glebmih/Hydro_USBL/Filter/V1/DesignFiles (2)/Design.pdf

## Filter Wizard

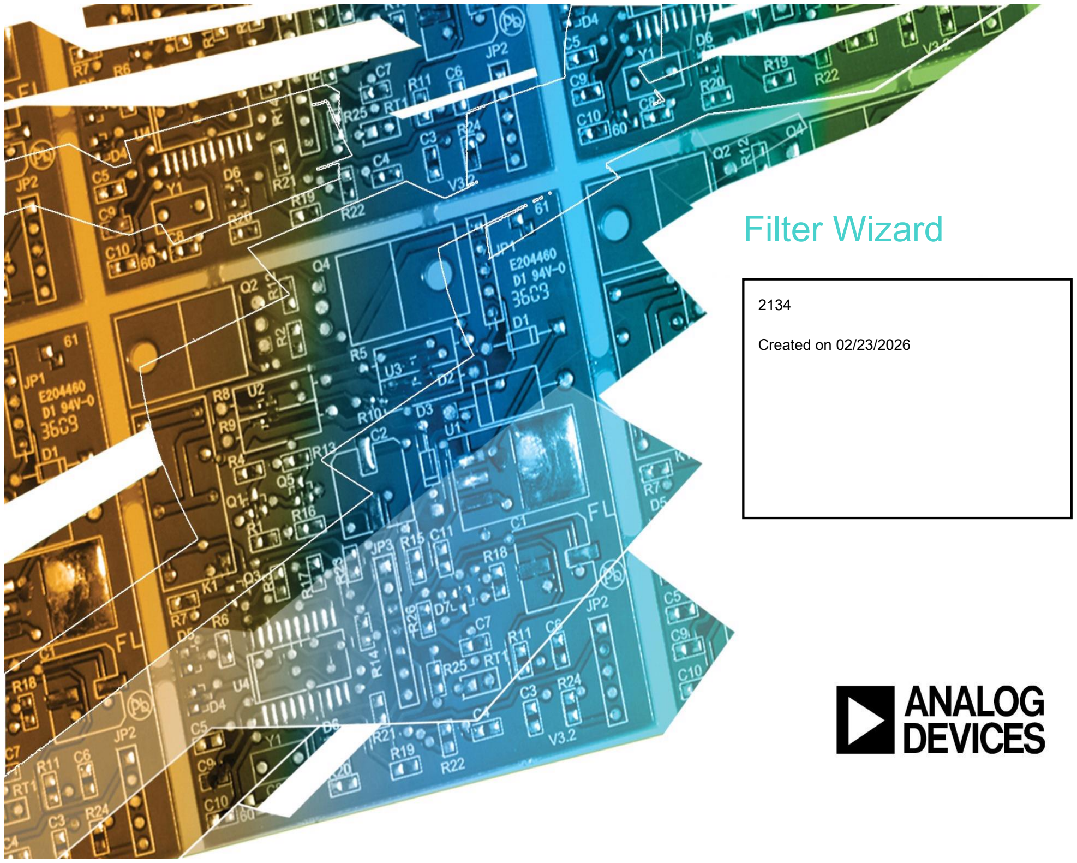
[picture p1: page 1]

2134

Created on 02/23/2026

## Filter Wizard Design Report

Filter Requirements for Band-Pass, 4th order Chebyshev Specifications: Optimize: Specific Parts; +Vs: 3.3; -Vs: 0
Gain: 40 dB
Passband: -3dB at 15kHz
Stopband: -40dB at 150kHz
Component Tolerances: Capacitor = 5%; Resistor = 1%; Inductor = 5%; Op Amp GBW = 20% BOM: refer to BOM.csv file

Magnitude(dB)

Magnitude(Volts per Volt)

Phase(degrees)

Phase(radians)

Group Delay

Phase Delay

Step Response

Input Impedance Magnitude

Input Impedance Phase

Noise

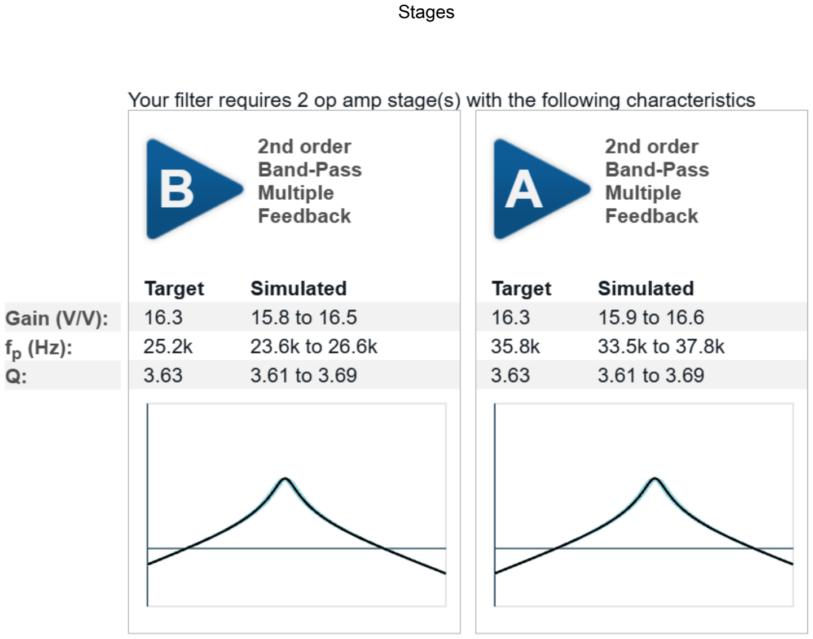
[picture p2: page 13]

Stages

Circuit

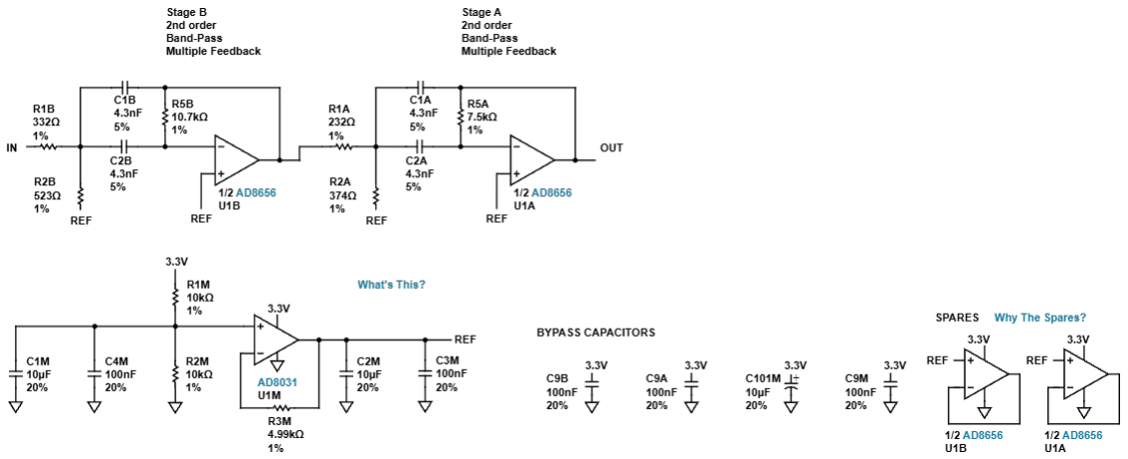
[picture p3: figure]
