glebmih/Hydro_USBL/Filter/V2/DesignFiles (1)/Design.pdf

## Filter Wizard

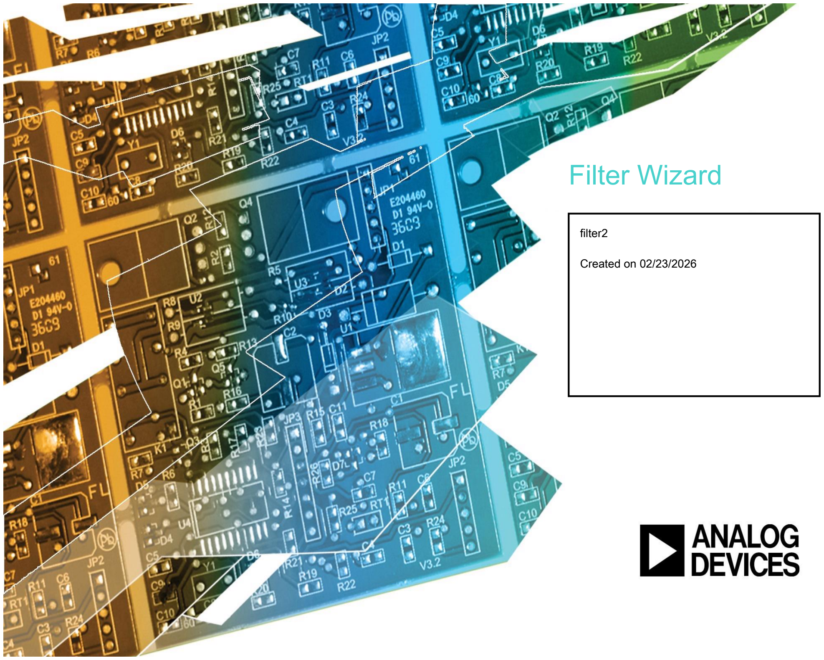
[picture p4: page 1]

filter2

Created on 02/23/2026

## Filter Wizard Design Report

Filter Requirements for Band-Pass, 8th order Butterworth Specifications: Optimize: Noise; +Vs: 3.3; -Vs: 0
Gain: 40 dB
Passband: -1dB at 10kHz
Stopband: -40dB at 40kHz
Component Tolerances: Capacitor = 5%; Resistor = 1%; Inductor = 5%; Op Amp GBW = 20% BOM: refer to BOM.csv file

Magnitude(dB)

Magnitude(Volts per Volt)

Phase(degrees)

Phase(radians)

Group Delay

Phase Delay

Step Response

Input Impedance Magnitude

Input Impedance Phase

Noise

Stages

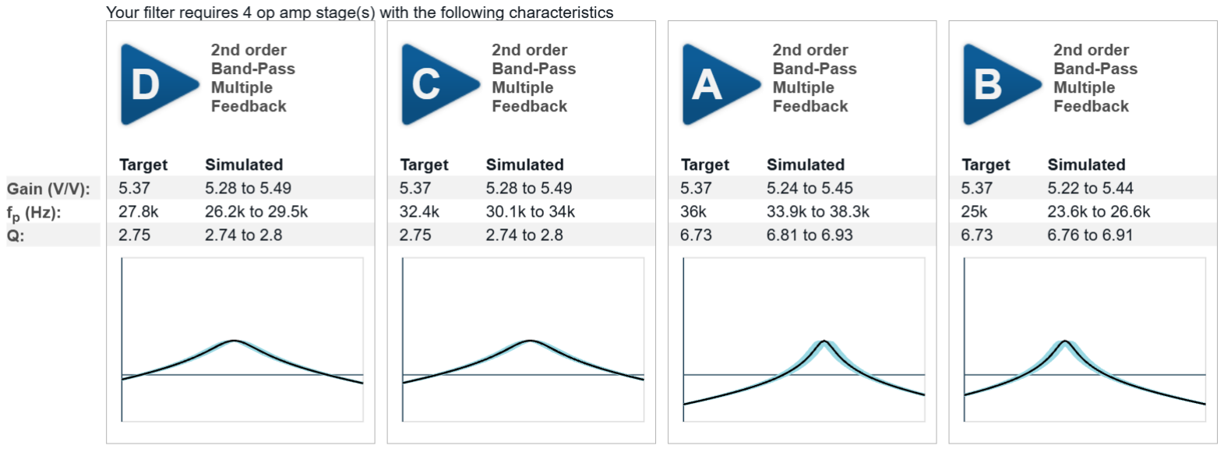
[picture p5: figure]

Circuit

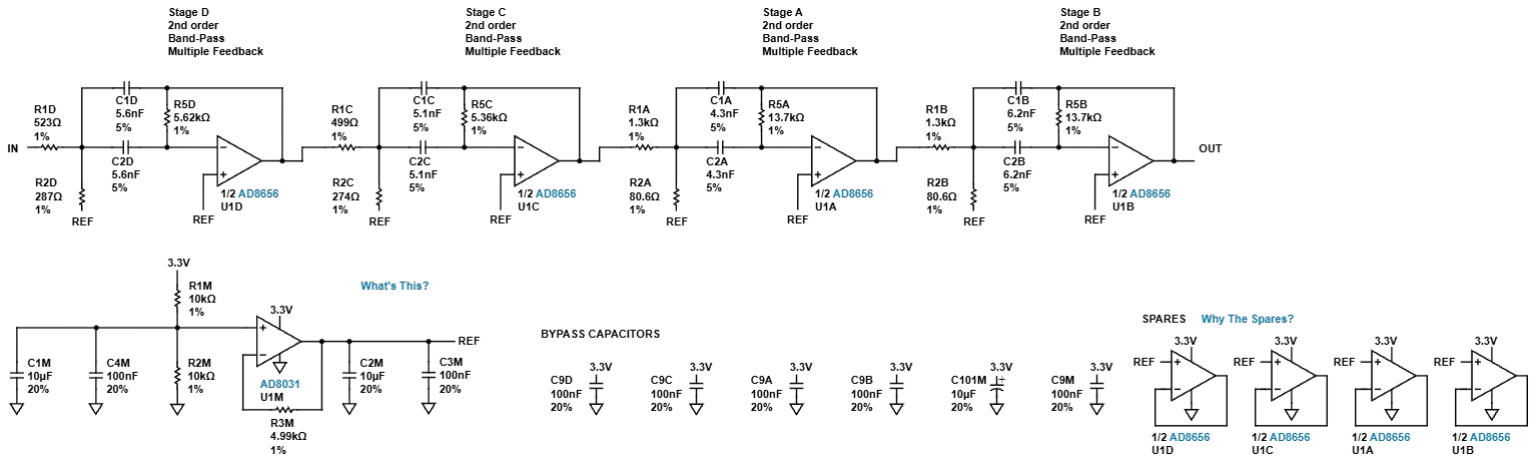
[picture p6: figure]
