glebmih/Hydro_USBL/PCB/Hydro_USBL_PCB/Project Outputs for Hydro_USBL_PCB/Hydro_USBL_PCB.xlsx

Line # | Library Reference | Name | Description | Designator | Quantity
 | Capacitor_10u_10_35V_X7R_1210C | Capacitor | Конденсатор 1210C ёмкостью 10 мк 10%, 35 В, X7R | C1, C3, C8, C11, C51, C56, C60 | 7
 | Capacitor_0,1u_10_50V_X7R_0603C | Capacitor | Конденсатор 0603C ёмкостью 0,1 мк 10%, 50 В, X7R | C2, C4, C22A, C22B, C22C, C22D, C23A, C23B, C23C, C23D, C24A, C24B, C24C, C24D, C28A, C28B, C28C, C28D, C31A, C31B, C31C, C31D, C36, C37, C38, C39, C42, C43, C44, C49, C50, C52, C53, C61, C67 | 35
 | Capacitor_1u_10_25V_X7R_0603C | Capacitor | Конденсатор 0603C ёмкостью 1 мк 10%, 25 В, X7R | C5, C6, C40, C41, C59, C63 | 6
 | 50SVPF68M | Capacitor | Конденсатор алюминиевый полимерный 68мкФ 50В ±20% (10х12.6мм) для поверхностного монтажа 0.02Ом 4300мА 5000час 105°С | C7, C9 | 2
 | Capacitor_1n_5_50V_NP0_0603C | Capacitor | Конденсатор 0603C ёмкостью 1 н 5%, 50 В, NP0 | C10, C15, C20A, C20B, C20C, C20D | 6
 | Capacitor_100p_5_630V_NP0_1206C | Capacitor | Конденсатор 1206C ёмкостью 100 п 5%, 630 В, NP0 | C19A, C19B, C19C, C19D | 4
 | Capacitor_10u_10_10V_X7R_0603C | Capacitor | Конденсатор 0603C ёмкостью 10 мк 10%, 10 В, X7R | C21A, C21B, C21C, C21D, C27A, C27B, C27C, C27D | 8
 | Capacitor_3.3n_5_50V_NP0_0603C | Capacitor | Конденсатор 0603C ёмкостью 3,3 н 5%, 50 В, NP0 | C25A, C25B, C25C, C25D, C26A, C26B, C26C, C26D, C29A, C29B, C29C, C29D, C30A, C30B, C30C, C30D, C32A, C32B, C32C, C32D, C33A, C33B, C33C, C33D, C54, C62 | 26
 | Capacitor_4,7u_10_50V_X7R_1206C | Capacitor | Конденсатор 1206C ёмкостью 4,7 мк 10%, 50 В, X7R | C34 | 1
 | Capacitor_0,47u_10_50V_X7R_0603C | Capacitor | Конденсатор 0603C ёмкостью 0,47 мк 10%, 50 В, X7R | C35 | 1
 | Capacitor_2,2u_10_50V_X7R_1206C | Capacitor | Конденсатор 1206C ёмкостью 2,2 мк 10%, 50 В, X7R | C45, C46 | 2
 | Capacitor_12p_5_50V_NP0_0603C | Capacitor | Конденсатор 0603C ёмкостью 12 п 5%, 50 В, NP0 | C47, C48 | 2
 | Capacitor_22u_10_25V_X7R_1210C | Capacitor | Конденсатор 1210C ёмкостью 22 мк 10%, 25 В, X7R | C55, C57, C58, C64, C65, C66 | 6
 | LD1117S33CTR | LD1117S33CTR | Линейный стабилизатор напряжения | D1 | 1
 | AD8031 | AD8031 | Операционный усилитель, 80МГц, 1-канал, 35В/мкс, Voltage Feedback, Rail-to-Rail | DA1A, DA1B, DA1C, DA1D | 4
 | REF3030AIDBZR | REF3030AIDBZR | Источник опорного напряжения, 3В | DA2 | 1
 | AP63200 | AP63200 | DC-DC понижающий преобразователь, Vin: 3.8 - 40 В, adj, 2 А | DA3, DA4 | 2
 | ADP150AUJZ-3.3 | ADP150AUJZ-3.3 | Стабилизатор напряжения 3.3В 150мА | DA5 | 1
 | UCC27211 | UCC27211 | Полумостовой драйвер затвора для mosfet транзисторов | DD1, DD2 | 2
 | AD8656 | AD8656 | Операционный усилитель 28МГц, CMOS, 2-канала, Rail-to-Rail | DD3A, DD3B, DD3C, DD3D, DD4A, DD4B, DD4C, DD4D | 8
 | STM32H743VIT6 | STM32H743VIT6 | Микроконтроллер, 32-Бит, Cortex-M7, 480МГц, 2Мб Flash, 1Мб SRAM, 82 I/O | DD5 | 1
 | MAX485CSA | MAX485CSA | RS-485 приёмопередатчик | DD6 | 1
 | BLM18AG102SN1D | BLM18AG102SN1D | Дроссель подавления ЭМП | FB1 | 1
 | LED | LED | Светодиод | HL1 | 1
 | LED | LED | Светодиод | HL2 | 1
 | LED | LED | Светодиод | HL3, HL4 | 2
 | Inductance_RM8 | Inductance_RM8 | Индуктивность на сердечнике RM8 | L1 | 1
 | SP43-150K | SP43-150K | Индуктивность на 15 мкГн, номинальный ток 1,3 А | L2, L3 | 2
 | Resistor_10k_1_0603 | Resistor | Резистор номиналом 10 кОм 1% | R1, R2, R3, R4, R19A, R19B, R19C, R19D, R20A, R20B, R20C, R20D, R32, R41, R46, R49, R53, R54 | 18
 | Resistor_3.3_1_0603 | Resistor | Резистор номиналом 3,3 Ом 1% | R5, R6, R7, R8 | 4
 | Resistor_47_1_0805 | Resistor | Резистор номиналом 47 Ом 1% | R9, R10 | 2
 | Resistor_33_1_2512 | Resistor | Резистор номиналом 33 Ом 1% | R11, R12, R13, R14 | 4
 | Resistor_1k_0805 | Resistor | Резистор номиналом 1 кОм 1% | R15A, R15B, R15C, R15D | 4
 | Resistor_1.0k_1_0603 | Resistor | Резистор номиналом 1,0 кОм 1% | R16A, R16B, R16C, R16D, R44, R45, R47, R50, R52 | 9
 | Resistor_470k_1_0603 | Resistor | Резистор номиналом 470 кОм 1% | R17A, R17B, R17C, R17D | 4
 | Resistor_12k_1_0603 | Resistor | Резистор номиналом 12 кОм 1% | R18A, R18B, R18C, R18D | 4
 | Resistor_8.2k_1_0603 | Resistor | Резистор номиналом 8,2 кОм 1% | R21A, R21B, R21C, R21D | 4
 | Resistor_620_1_0603 | Resistor | Резистор номиналом 620 Ом 1% | R22A, R22B, R22C, R22D | 4
 | Resistor_4.7k_1_0603 | Resistor | Резистор номиналом 4,7 кОм 1% | R23A, R23B, R23C, R23D, R24A, R24B, R24C, R24D | 8
 | Resistor_560_1_0603 | Resistor | Резистор номиналом 560 Ом 1% | R25A, R25B, R25C, R25D, R28A, R28B, R28C, R28D | 8
 | Resistor_220_1_0603 | Resistor | Резистор номиналом 220 Ом 1% | R26A, R26B, R26C, R26D, R31A, R31B, R31C, R31D | 8
 | Resistor_6.2k_1_0603 | Resistor | Резистор номиналом 6,2 кОм 1% | R27A, R27B, R27C, R27D | 4
 | Resistor_1.5k_1_0603 | Resistor | Резистор номиналом 1,5 кОм 1% | R29A, R29B, R29C, R29D | 4
 | Resistor_16k_1_0603 | Resistor | Резистор номиналом 16 кОм 1% | R30A, R30B, R30C, R30D | 4
 | Resistor_200_1_0603 | Resistor | Резистор номиналом 200 Ом 1% | R33, R34, R35, R36 | 4
 | Resistor_0_5_0603 | Resistor | Резистор номиналом 0 Ом 5% | R42, R43 | 2
 | Resistor_5.1k_1_0603 | Resistor | Резистор номиналом 5,1 кОм 1% | R48 | 1
 | Resistor_11k_1_0603 | Resistor | Резистор номиналом 11 кОм 1% | R51 | 1
 | Resistor_120_1_1206 | Resistor | Резистор номиналом 120 Ом 1% | R55 | 1
 | Resistor_100k_1_0603 | Resistor | Резистор номиналом 100 кОм 1% | R56 | 1
 | TSS-TD-19XA-XTR | TSS-TD-19XA-XTR | Тактовая кнопка | S1, S2 | 2
 | Transformer_RM8 | Transformer_RM8 | Трансформатор на сердечнике RM8 | T1 | 1
 | SMA4007 | SMA4007 | Выпрямительный диод на 1000 В, ном. ток 1 А А | VD1, VD2 | 2
 | BAV99 | BAV99 | Диод импульсный, 2 х 0.2А, 70В, последовательное включение | VD3A, VD3B, VD3C, VD3D | 4
 | PSM712 | PSM712 | Защитный диод для линии RS-485 | VD4 | 1
 | USBLC6-4 | USBLC6-4 | Сборка защитных диодов для USB | VD5, VD7 | 2
 | BZV55-B12 | BZV55-B12 | Стабилитрон 12В, 5%, 0.5Вт | VD6 | 1
 | CSD18534Q5A | CSD18534Q5A | N-канальный MOSFET, 60 В, 50 А | VT1, VT2, VT3, VT4 | 4
 | AO3401A | AO3401A | P-канальный MOSFET | VT5 | 1
 | IRF9310TR | IRF9310TR | P-канальный MOSFET, 30 В, 20 А | VT6 | 1
 | XT30UPB-M | XT30UPB-M | 2-пиновый разъем с ключом | XP1 | 1
 | CWF-2 | CWF-2 | 2-пиновый разъем с ключом | XP2, XP4, XP5, XP6, XP7, XP8 | 6
 | PLS-6 | PLS-6 | Гребенка 6 пинов | XP3 | 1
 | X322525MOB4SI | X322525MOB4SI | Кварцевый резонатор SMD 25 МГц ±10ppm SMD-3225_4P | ZQ1 | 1
