glebmih/Hydro_USBL/(list of files, cad)

Other CAD files:
PCB/Hydro_USBL_PCB/Project Outputs for Hydro_USBL_PCB/ГИДР.123456.023-01.01/Mechanical models/Hydro_USBL_PCB(01).x_t
