glebmih/Hydro_USBL/PCB/Hydro_USBL_PCB/Project Outputs for Hydro_USBL_PCB/Sources/Документация/ГИДР.123456.023-01.[No Variations] СБ.PDF

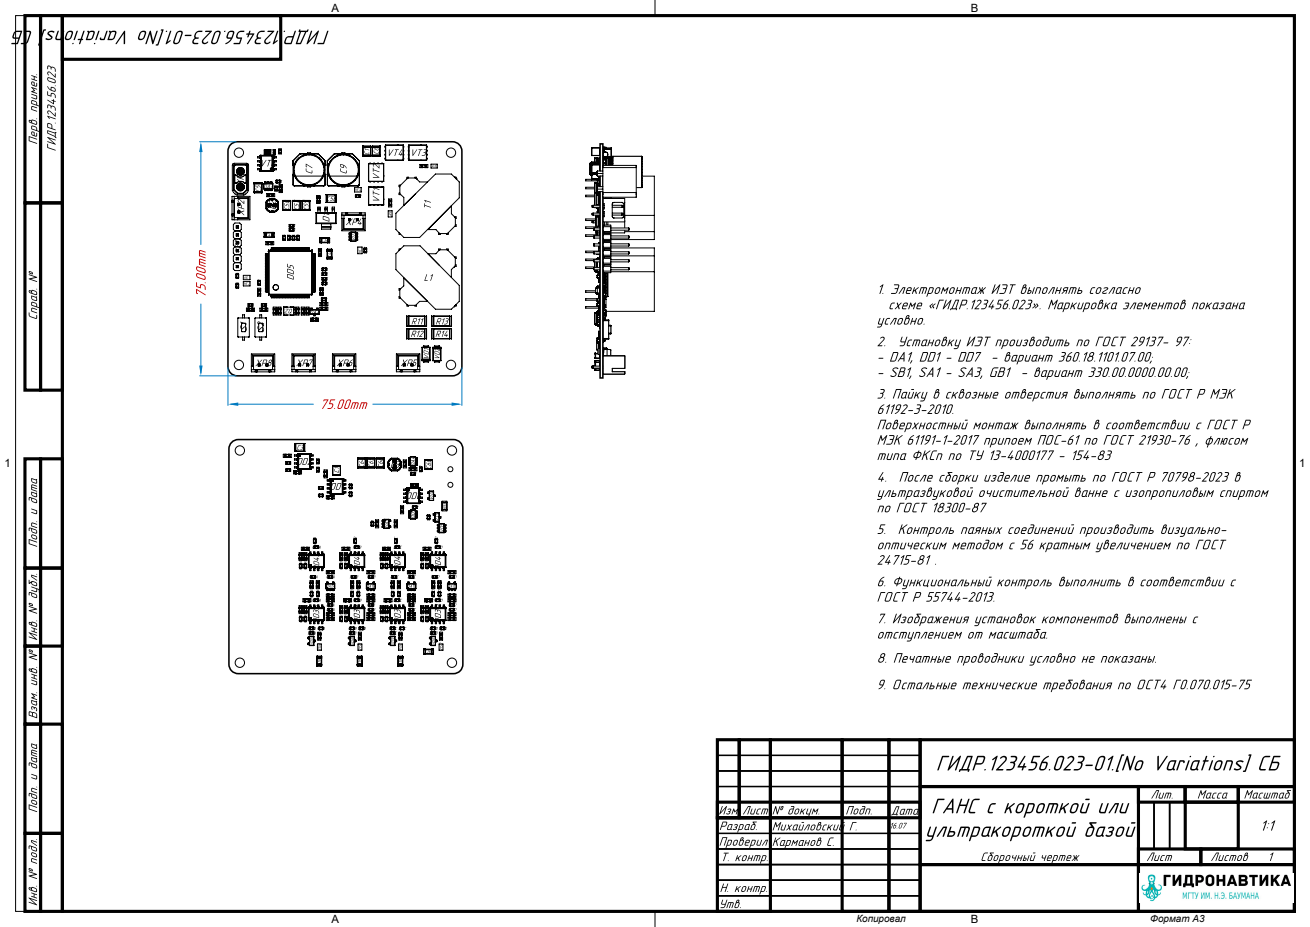
[picture p7: page 1]
