glebmih/Hydro_USBL/PCB/Hydro_USBL_PCB/Project Outputs for Hydro_USBL_PCB/Sources/Документация/ГИДР.123456.023-01.[No Variations] Э3.PDF

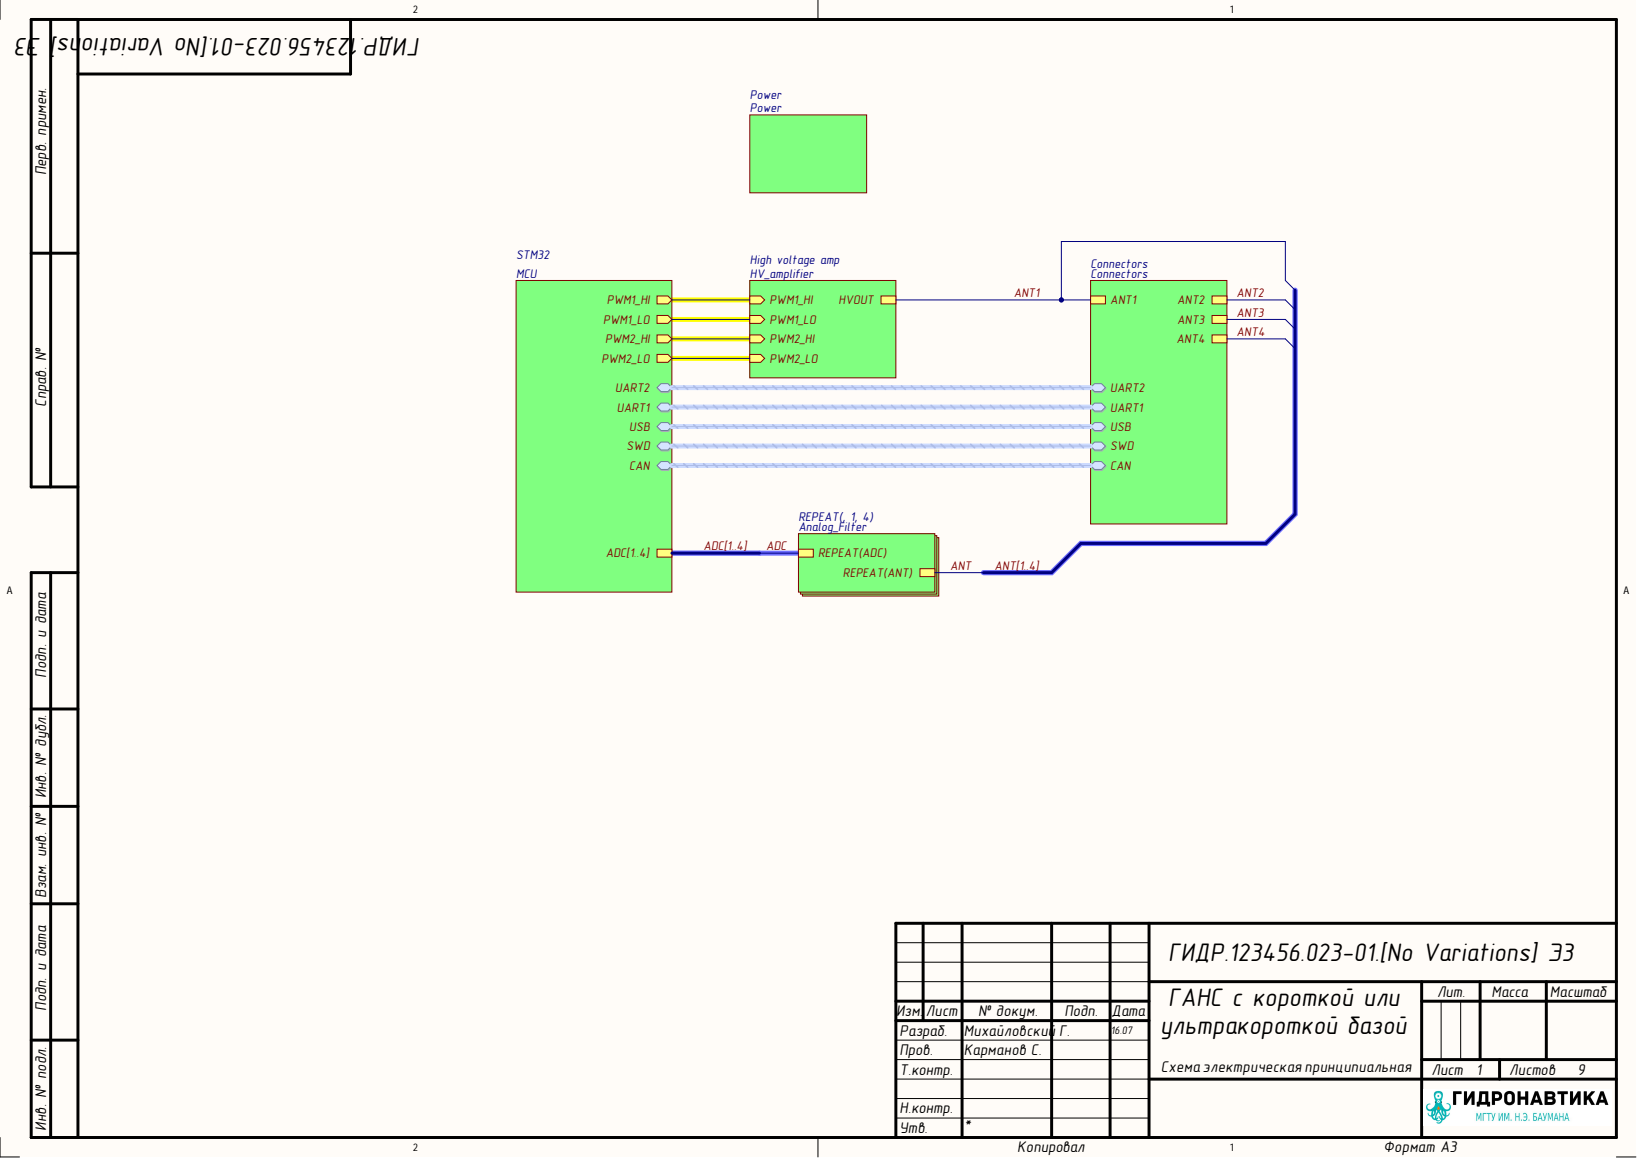
[picture p8: page 1]

ГИДР.123456.023-01.[No Variations] Э3

ГАНС с короткой или ультракороткой базой Схема электрическая принципиальная | Лит. | Масса | Масштаб

Изм. | Лист | № докум. | Подп. | Дата
Разраб. | | Михайловский Г. | | 16.07
Пров. | | Карманов С.
Т.контр. | | | | | Лист | Листов 9

Н.контр.
Утв. | *

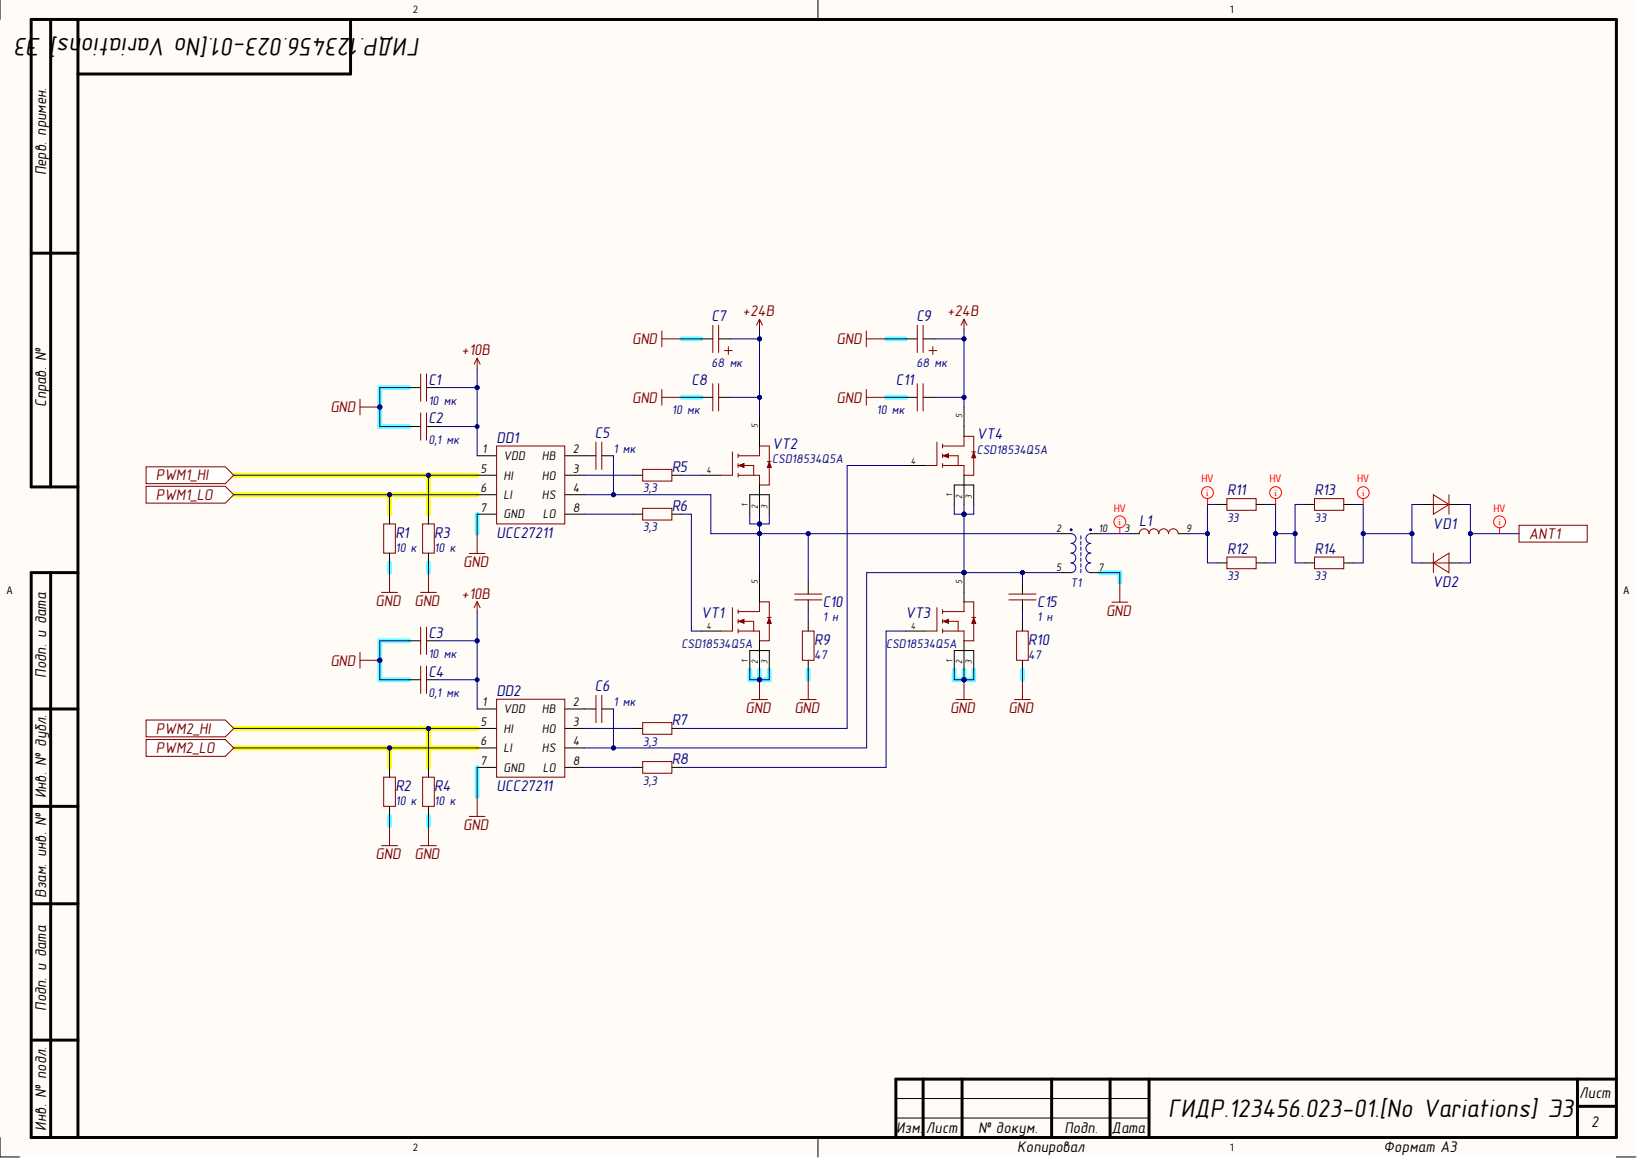
[picture p9: page 2]

Инв. № подл. Инв. № дубл. Подп. и дата Взам. инв. № Подп. и дата Перв. примен. Справ. №

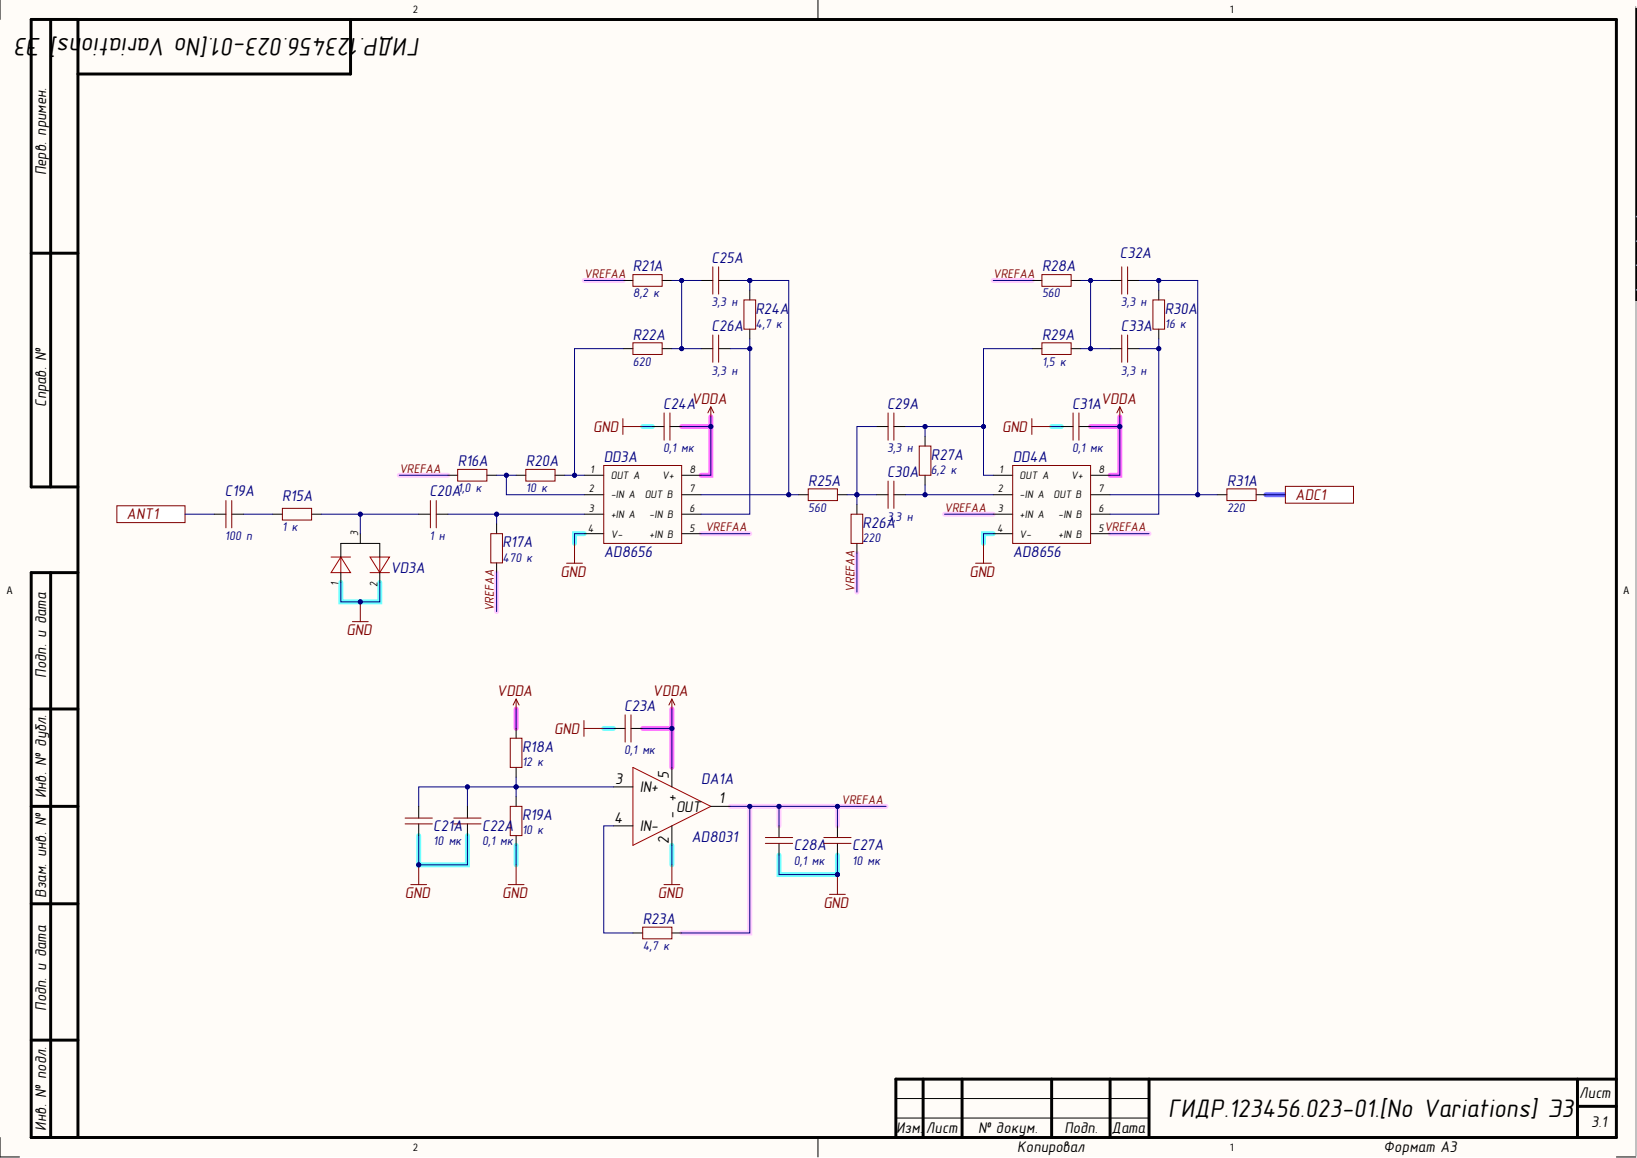
[picture p10: page 3]

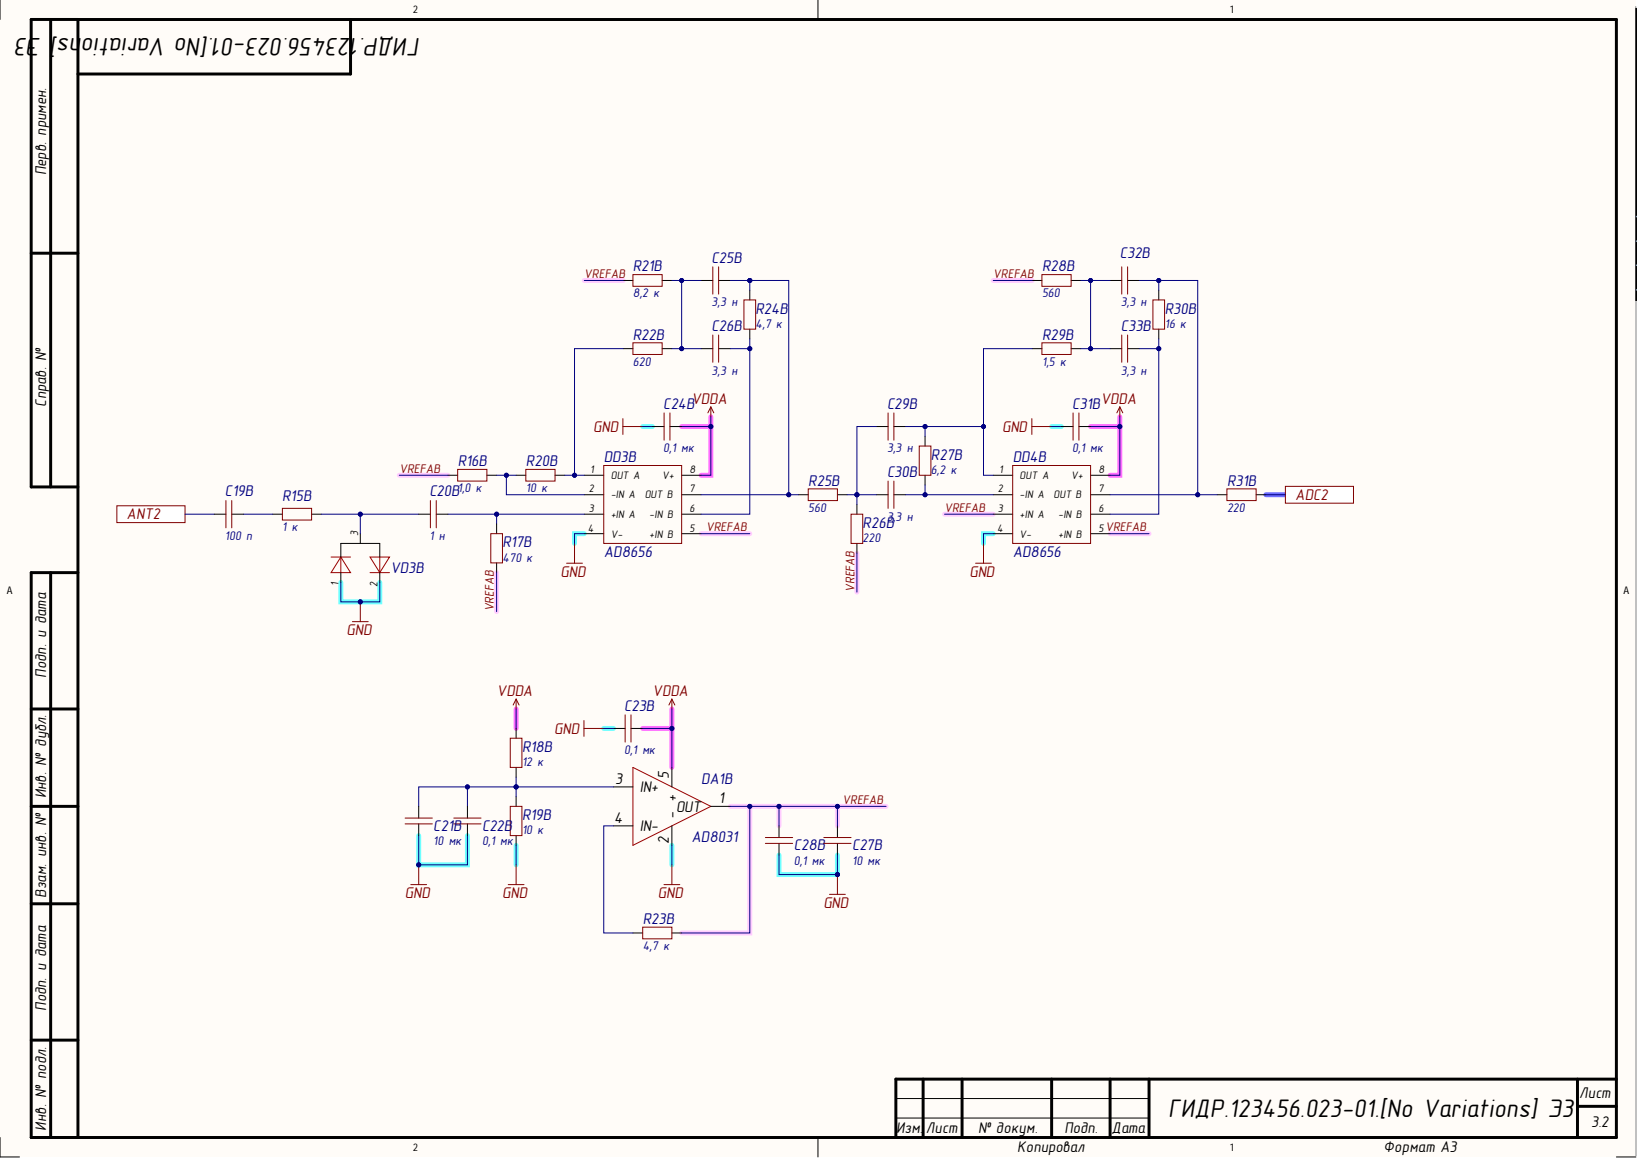
[picture p11: page 4]

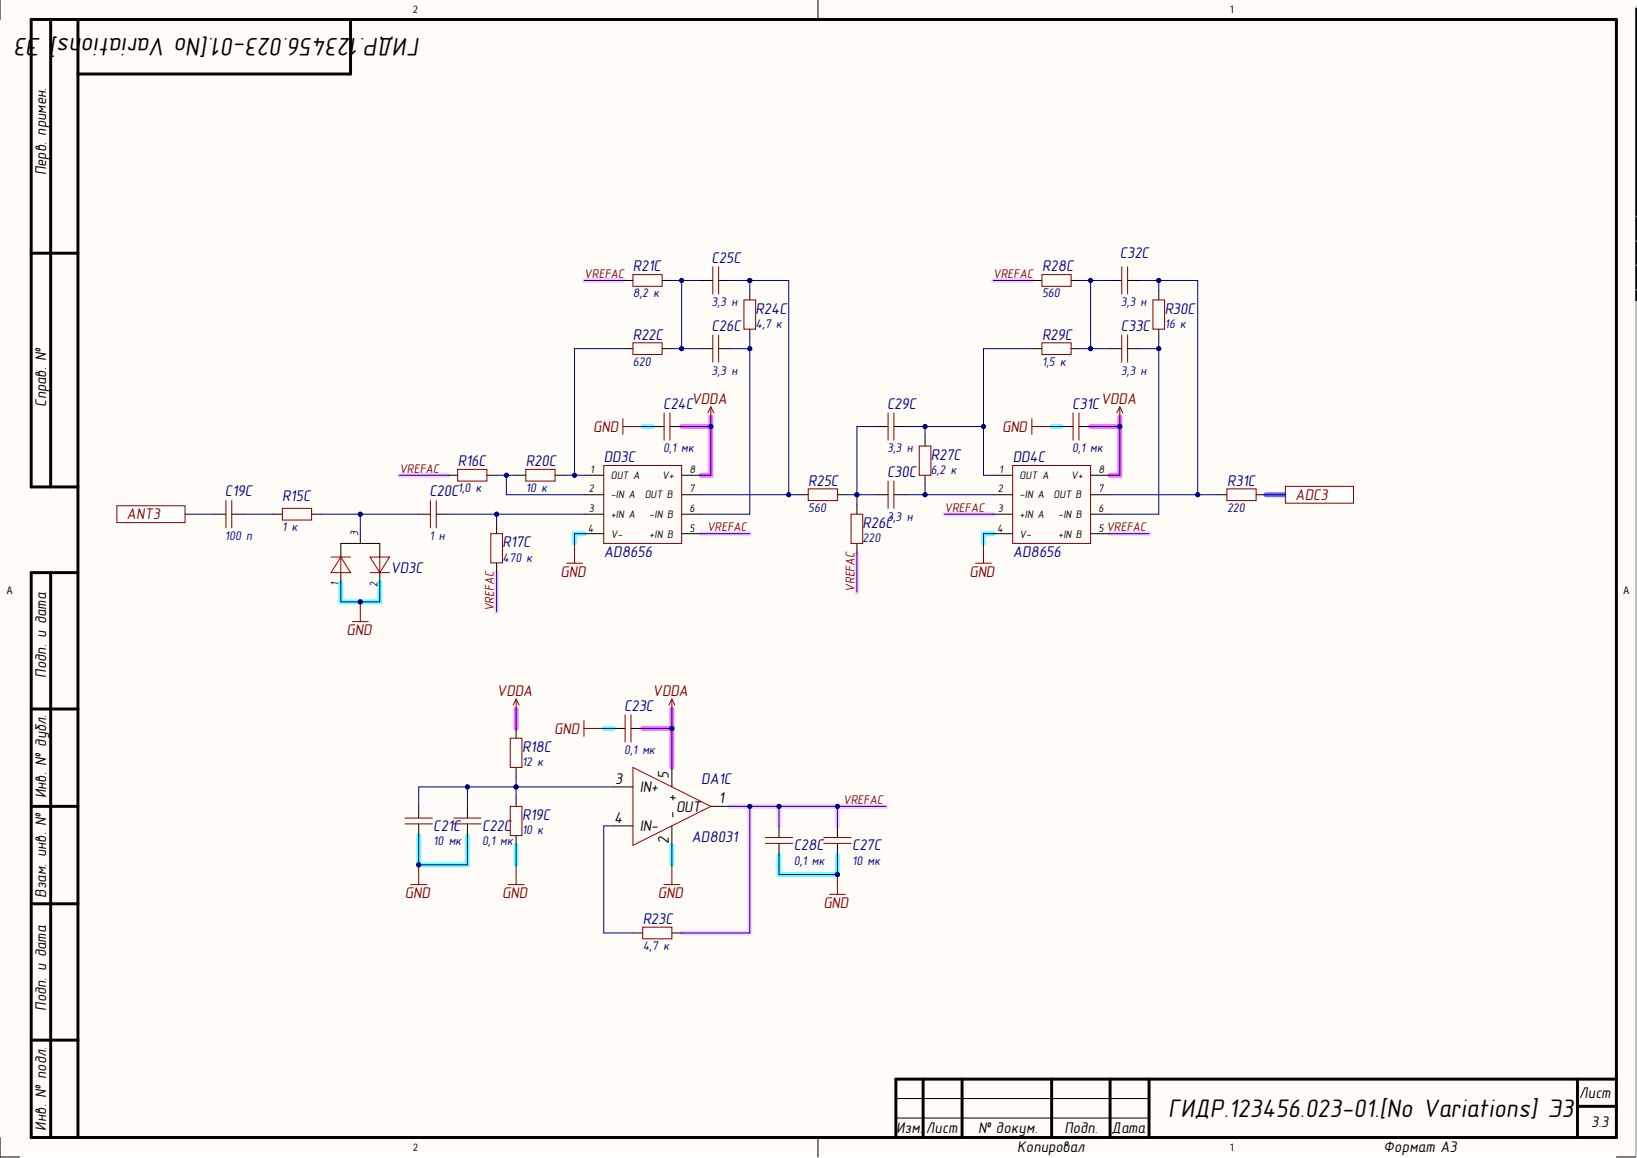
[picture p12: page 5]

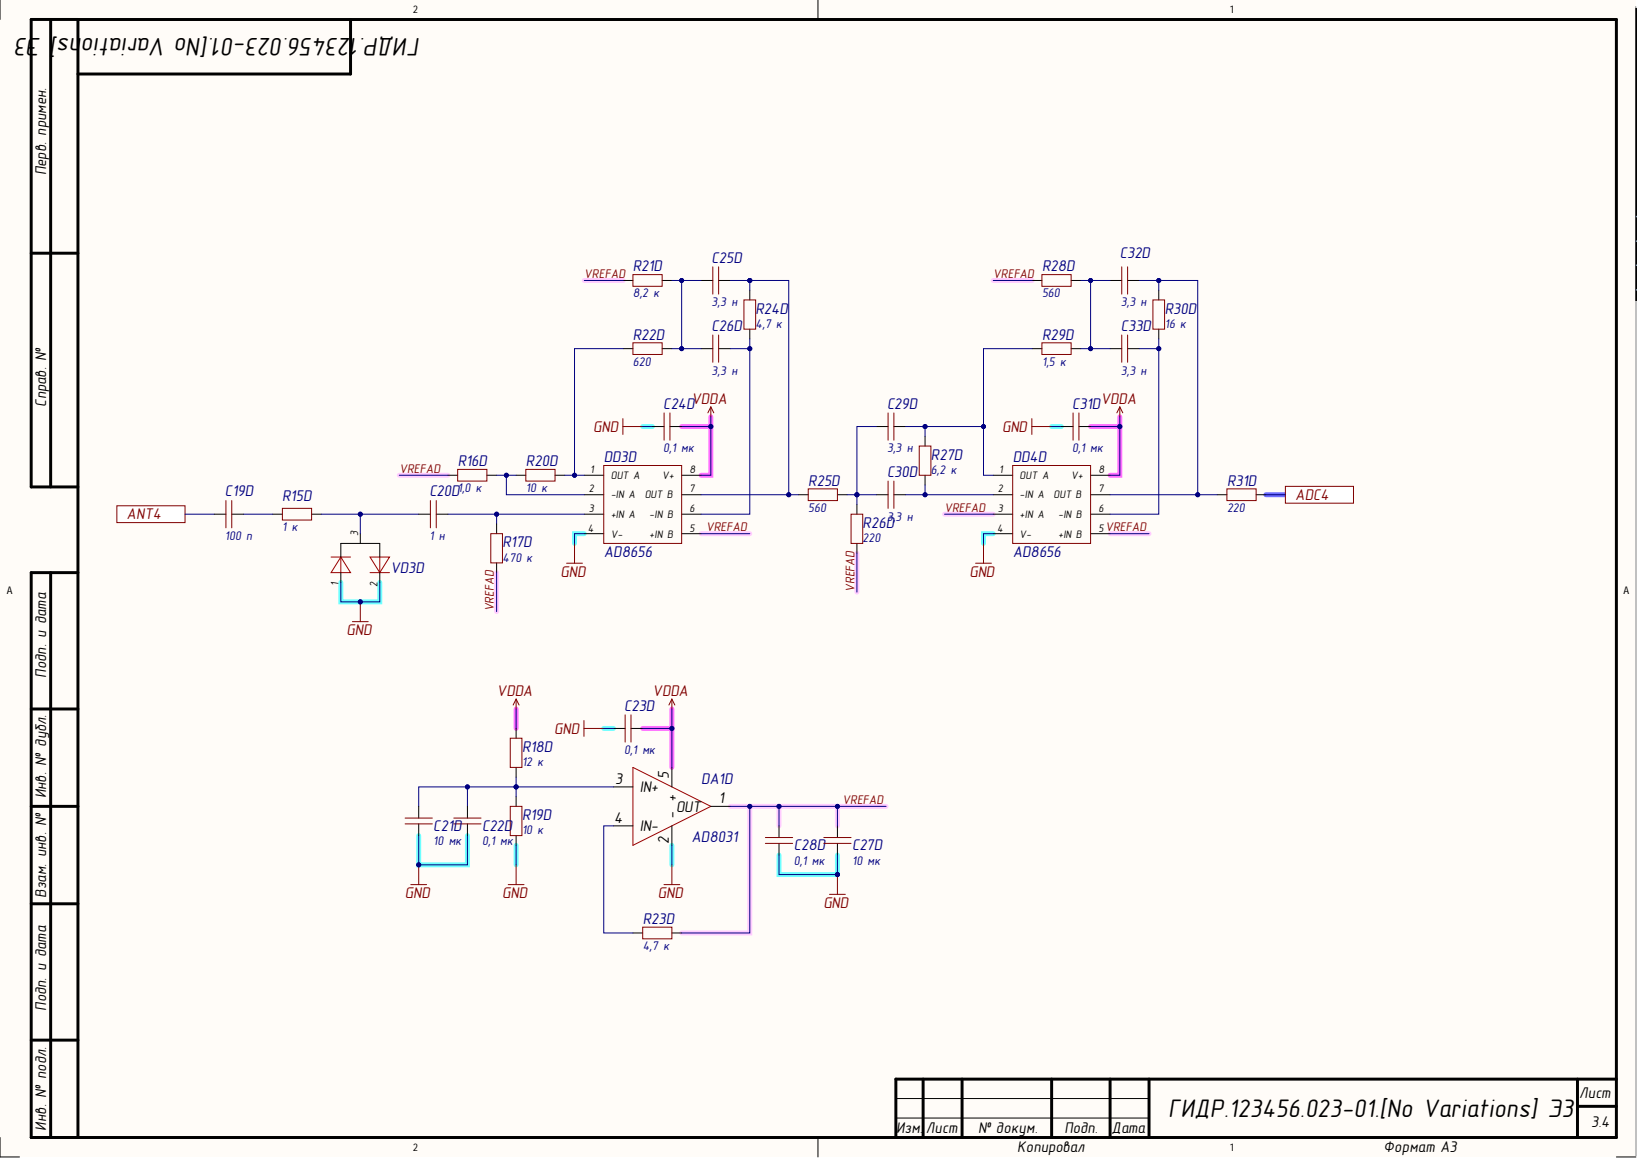
[picture p13: page 6]

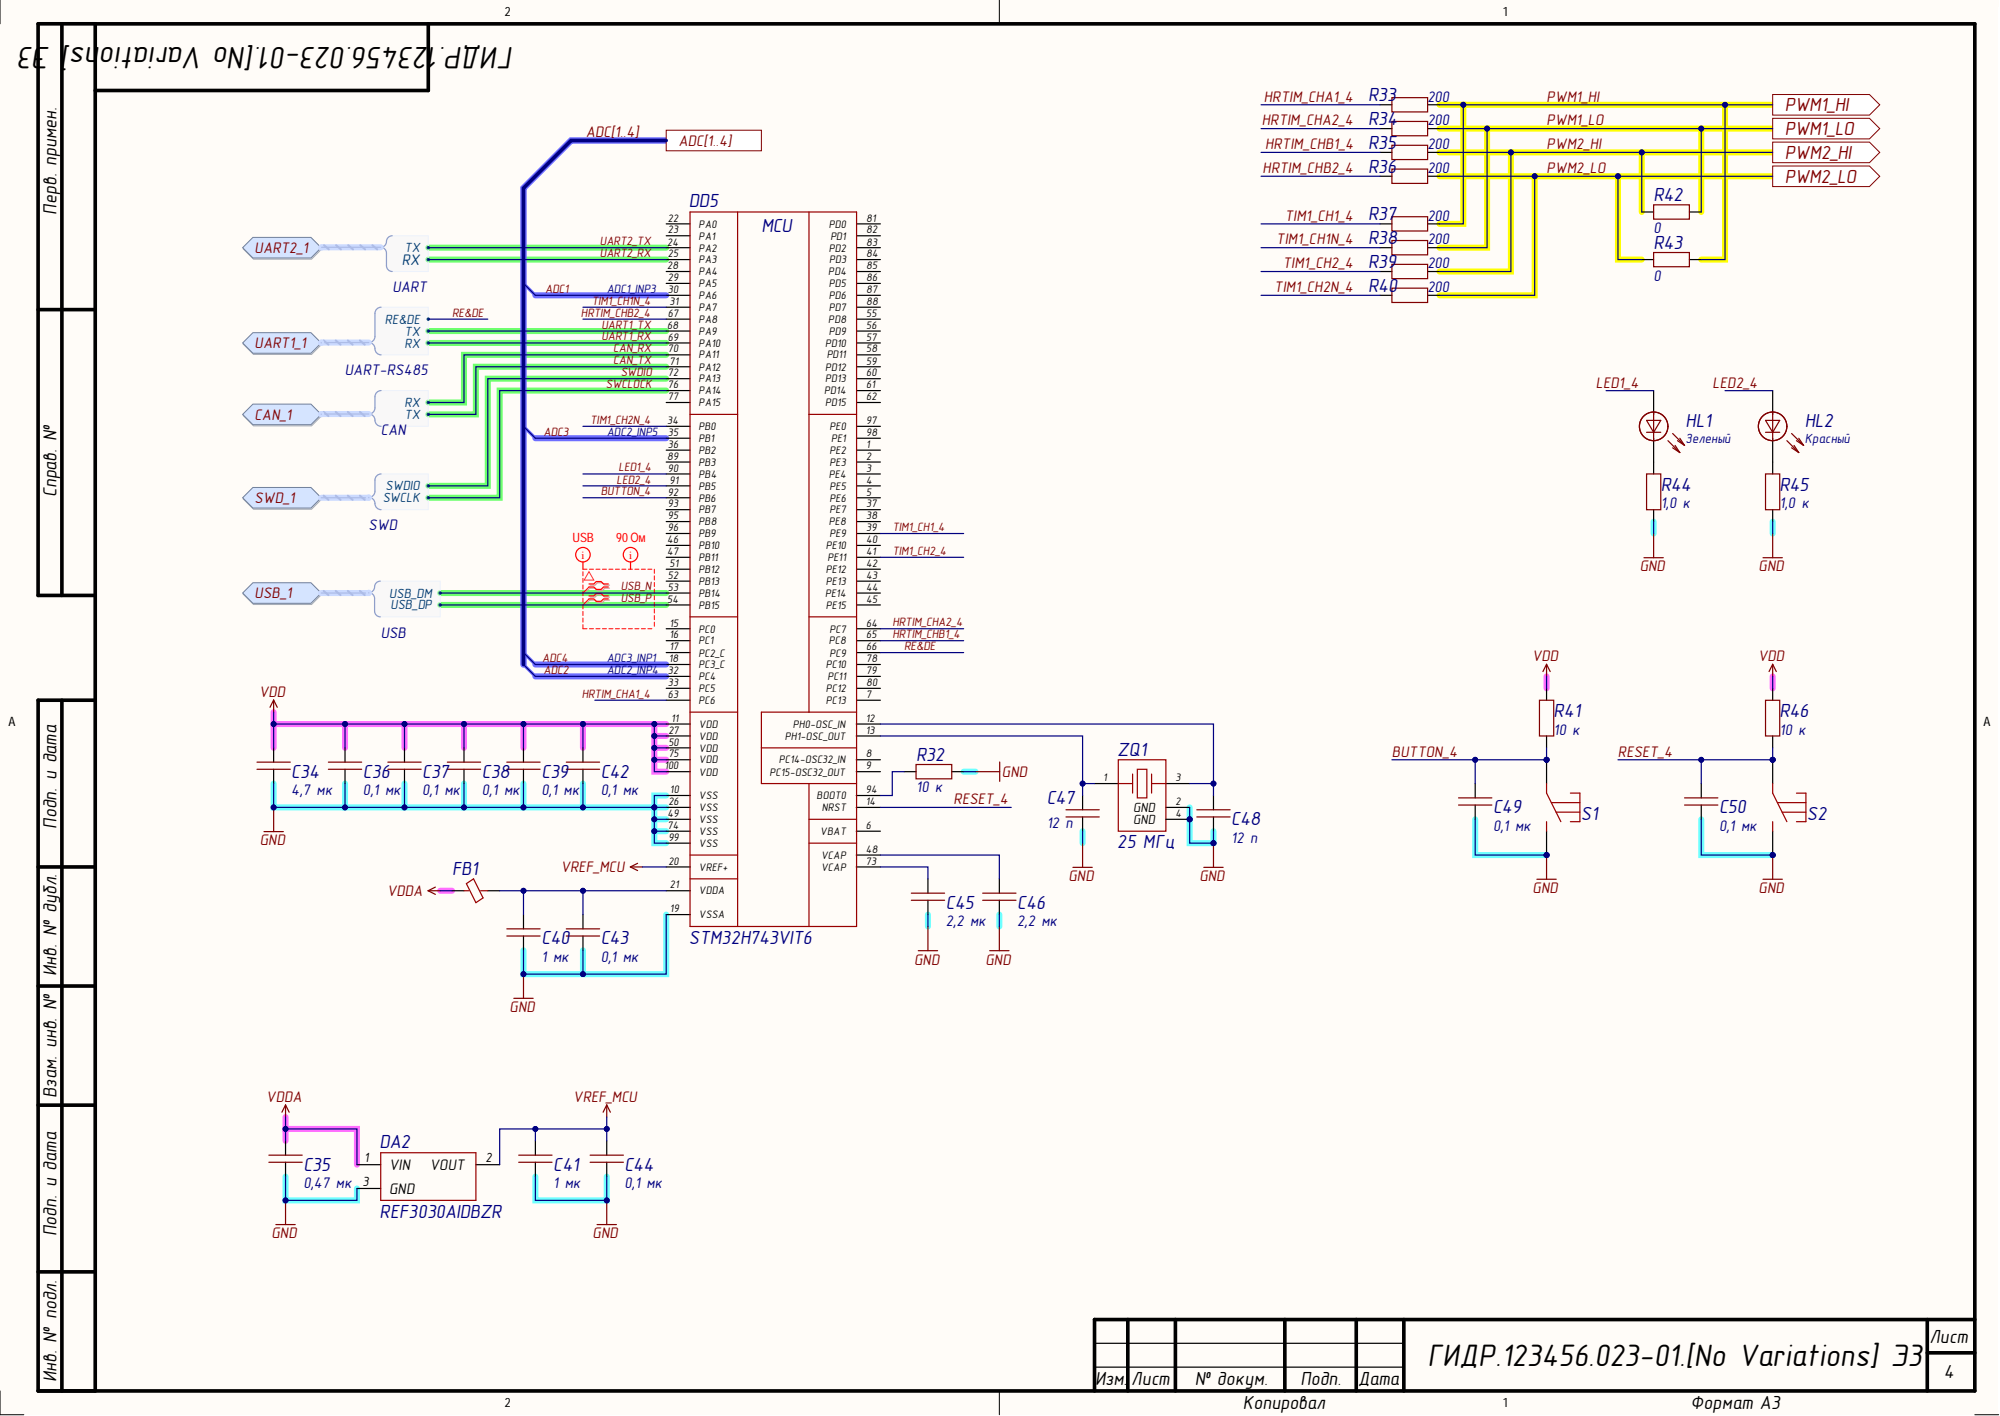
[picture p14: page 7]

Инв. № подл. Инв. № дубл. Подп. и дата Взам. инв. № Подп. и дата Перв. примен. Справ. №

PWM1_LO
PWM2_HI

PB3 89 | 2
PB4 90 | 3

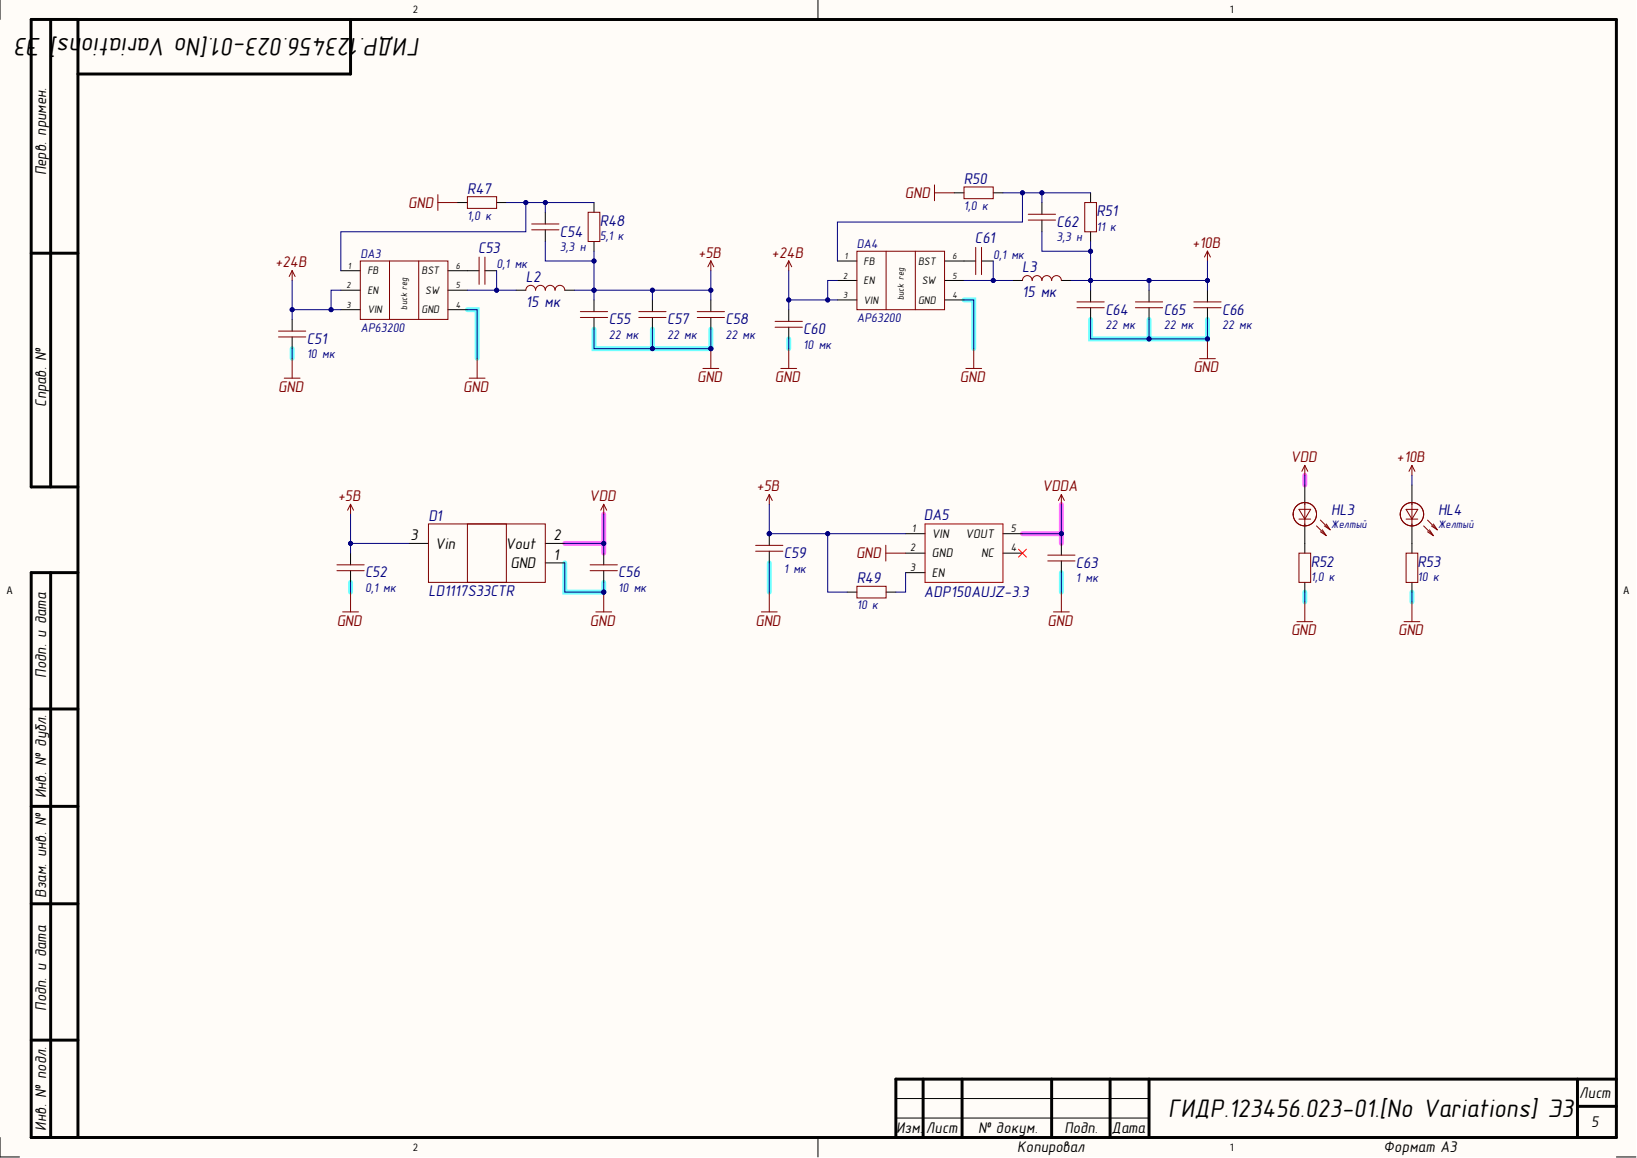
[picture p15: page 8]

Инв. № подл. Инв. № дубл. Подп. и дата Взам. инв. № Подп. и дата Перв. примен. Справ. №

BST

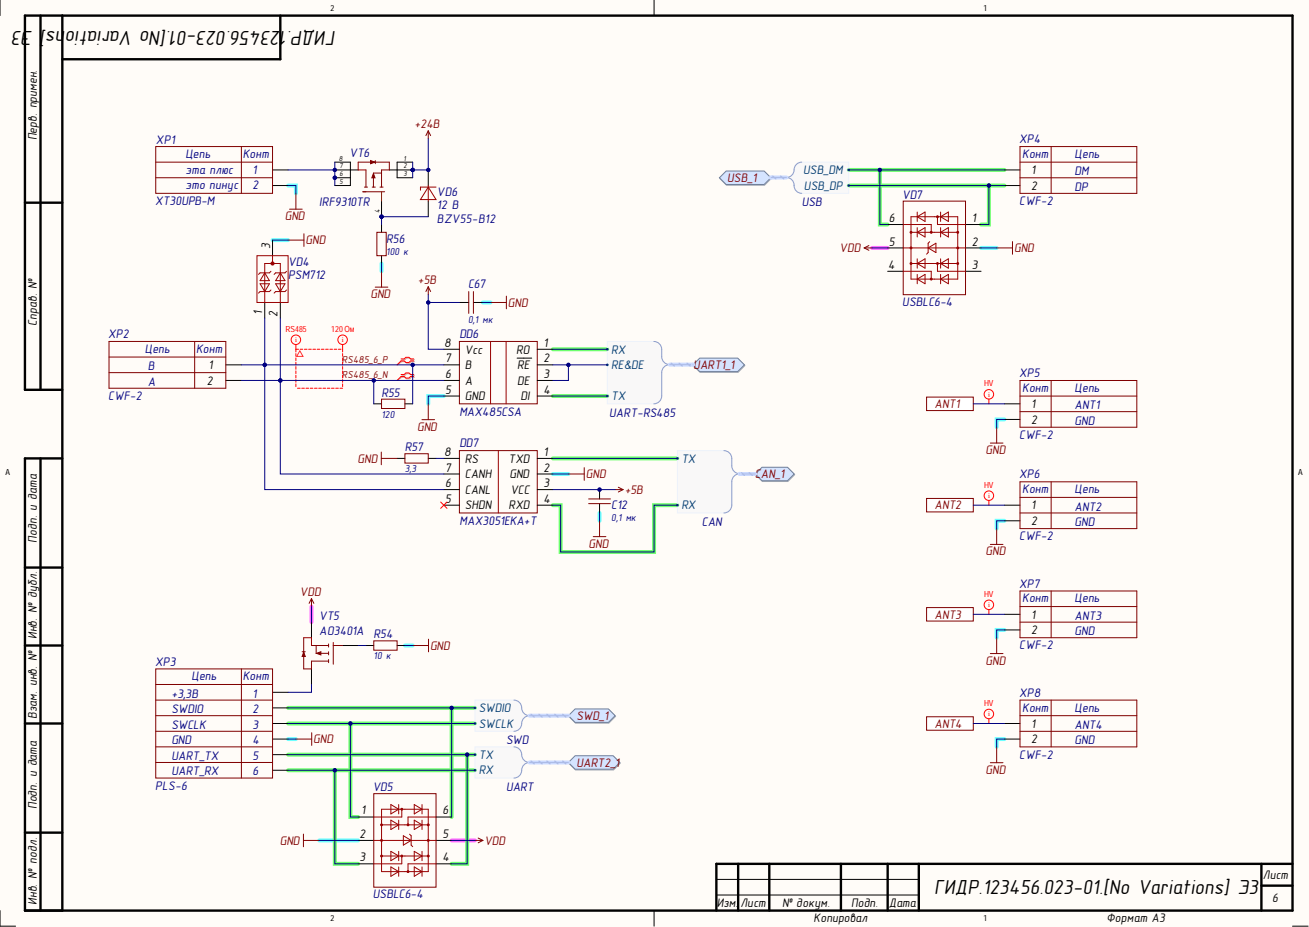
[picture p16: page 9]

Цепь | Конт
+3,3В | 1
