glebmih/Hydro_USBL/PCB/Hydro_USBL_PCB/Project Outputs for Hydro_USBL_PCB/Sources/Документация/ГИДР.123456.024-01.[No Variations].PDF

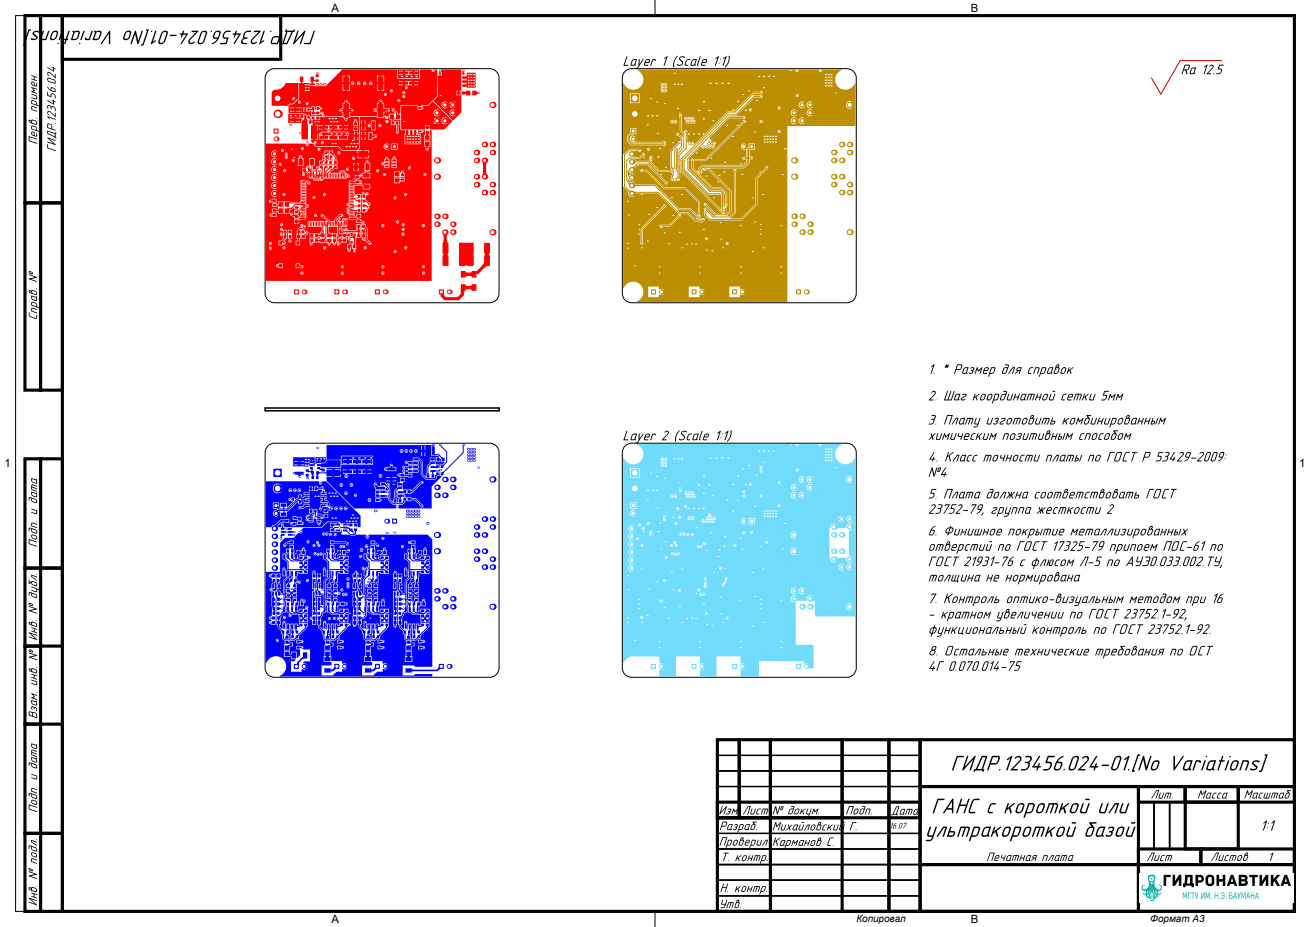
[picture p17: page 1]
