glebmih/Hydro_USBL/PCB/Hydro_USBL_PCB/Project Outputs for Hydro_USBL_PCB/ГИДР.123456.023-01.01/Документация/ГИДР.123456.023-01.01 СБ.PDF

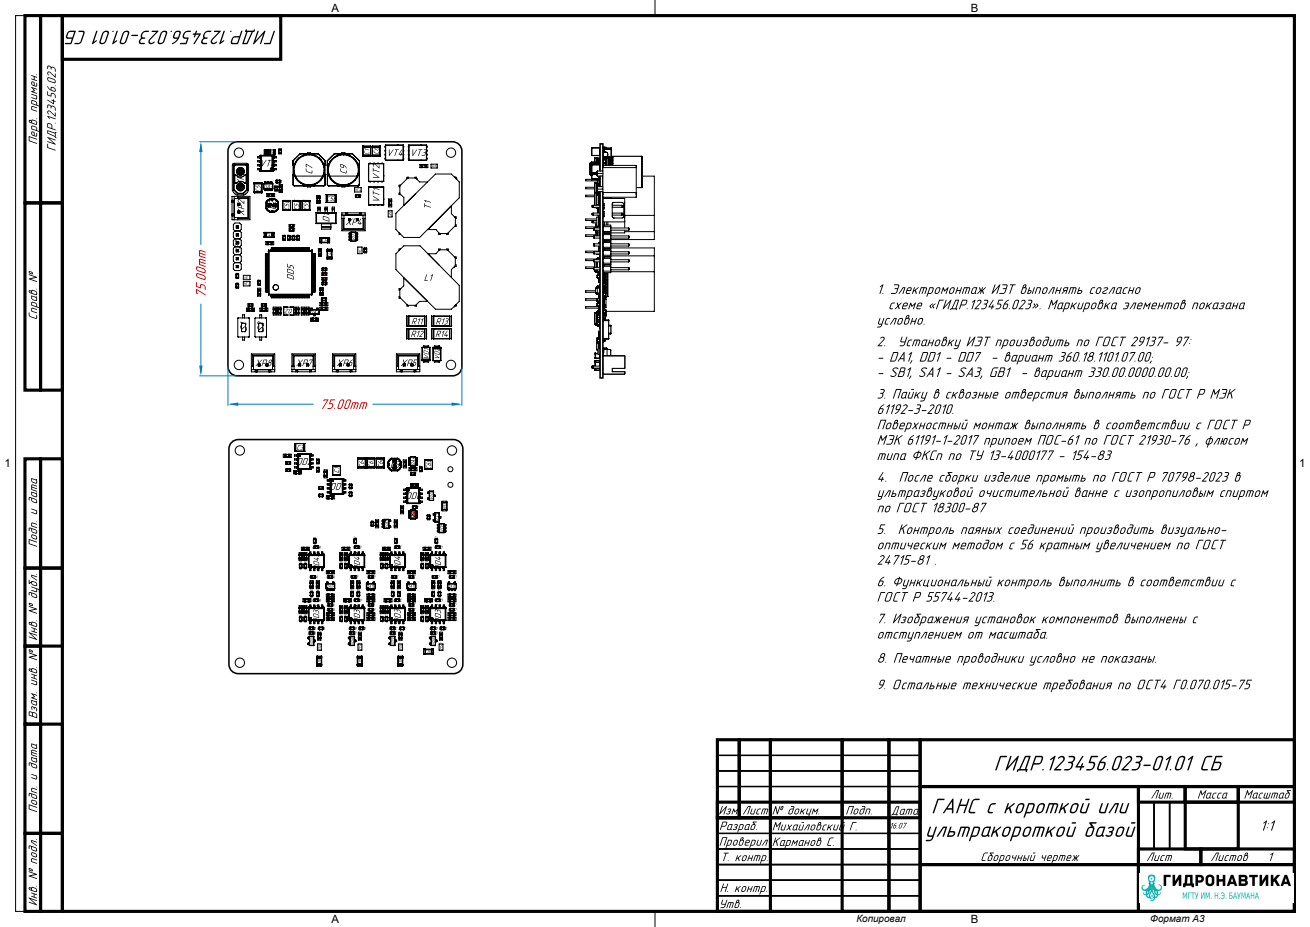
[picture p18: page 1]
