glebmih/Hydro_USBL/PCB/Hydro_USBL_PCB/Project Outputs for Hydro_USBL_PCB/ГИДР.123456.023-01.01/Документация/ГИДР.123456.024-01.01.PDF

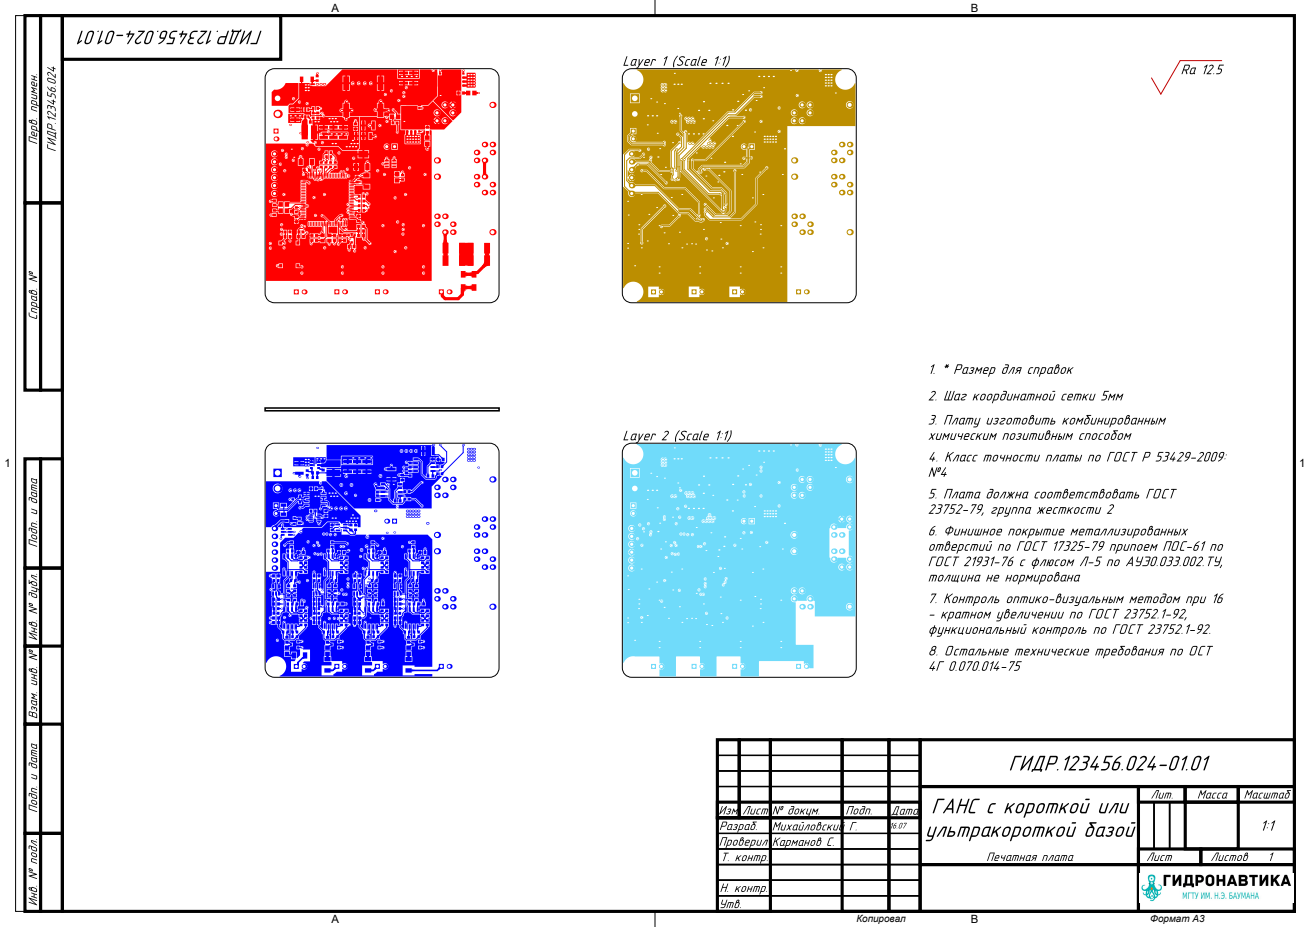
[picture p28: page 1]
