glebmih/Hydro_USBL/Filter/V3/DesignFiles (3)/LTspice/StageA_BandPassDeliyannisFriendNoPosFB_AD8655.asc

C1: cap; 3.3n
C2: cap; 3.3n
R1: res; 620
R2: res; 8.2k
R5: res; 4.7k
U1: AD8655
Named nets: V+, V-, OUT, IN, REF
This subcircuit is not simulatable.  
Please open one of the 
"Filter Design*.asc" schematics to 
simulate your Filter Wizard design.
stage1
