glebmih/Hydro_USBL/Filter/V3/DesignFiles (3)/LTspice/StageB_BandPassDeliyannisFriendNoPosFB_AD8655.asc

C1: cap; 3.3n
C2: cap; 3.3n
R1: res; 560
R2: res; 220
R5: res; 6.2k
U1: AD8655
Named nets: V+, V-, OUT, IN, REF
This subcircuit is not simulatable.  
Please open one of the 
"Filter Design*.asc" schematics to 
simulate your Filter Wizard design.
stage2
