glebmih/Hydro_USBL/Filter/V3/DesignFiles (3)/LTspice/NoiseAnalysis.asc

C1: cap; 10n
R1: res; 10k
R2: res; 10k
R3: res; 1k
STAGE1: StageA_BandPassDeliyannisFriendNoPosFB_AD8655
STAGE2: StageB_BandPassDeliyannisFriendNoPosFB_AD8655
STAGE3: StageC_BandPassDeliyannisFriendNoPosFB_AD8655
U1: AD8655
V1: voltage; 1.65
V2: voltage; 3.3
V3: voltage; 0
VNOISE: voltage; SINE(1.65 136m 2.2k); AC 1
Named nets: 0, Vp, Vn, OUT1, Vref, OUT2, OUT, IN
.NOISE V(OUT) VNOISE DEC 100 2.24k 402k 
.save V(*?*) I(*?*)
If you're having trouble with simulation try the following:
 
- Ensure that LTspice circuit folder is unzipped.  LTspice won't 
be able to locate subcircuits if the folders are still zipped.
 
- Update LTspice - devices that have been recently added to LTspice
won't be available unless you update by clicking Tools -> Sync Release.
