glebmih/Hydro_USBL/Filter/V3/DesignFiles (3)/LTspice/TransientAnalysis.asc

C1: cap; 10n
C2: cap; 2250p
C3: cap; 15600p
L1: ind; 16m; Rser=1m
R1: res; 10k
R2: res; 10k
R3: res; 1k
R4: res; 450
STAGE1: StageA_BandPassDeliyannisFriendNoPosFB_AD8655
STAGE2: StageB_BandPassDeliyannisFriendNoPosFB_AD8655
STAGE3: StageC_BandPassDeliyannisFriendNoPosFB_AD8655
U1: AD8655
V1: voltage; 1.7
V2: voltage; 3.3
V3: voltage; 0
VIN1: voltage; SINE(0 10m 26k); AC 1
VIN: voltage; SINE(0 10m 30k 0 0 0 1000); AC 1
Named nets: 0, Vp, Vn, OUT1, Vref, IN, OUT2, OUT
.tran 1m
.save V(*?*) I(*?*)
If you're having trouble with simulation try the following:
 
- Ensure that LTspice circuit folder is unzipped.  LTspice won't 
be able to locate subcircuits if the folders are still zipped.
 
- Update LTspice - devices that have been recently added to LTspice
won't be available unless you update by clicking Tools -> Sync Release.
