glebmih/Hydro_USBL/Filter/Antennae/antennae_33_28_20.asc

C1: cap; 2250p
C2: cap; 15600p
I1: current; ""; AC 1 0
L1: ind; 16m; Rser=1m
R1: res; 450
Named nets: 0
.ac lin 1000 10k 45k
.save V(*?*) I(*?*)
