glebmih/Hydro_USBL/Filter/modem v1/Draft1.asc

C1: cap; 0.1µ
R1: res; 10k
R2: res; 10k
R3: res; 820k
R4: res; 510k
R5: res; 240k
R6: res; 130k
R7: res; 120k
R8: res; 220k
R9: res; 91k
R10: res; 820k
R11: res; 240k
R12: res; 130k
R13: res; 120k
R14: res; 220k
R15: res; 91k
U1: AD8065
U2: LTC1562
V1: voltage; 6
V2: voltage; 3
V3: voltage; SINE(0 1m 30k 0 0 0 0); AC 1 0
Named nets: 0, V, Vref, OUT, IN
.ac dec 1000 100 500k
.tran 1m
