glebmih/Hydro_USBL/(list of files, drawings)

Other design files:
PCB/Hydro_USBL_PCB/Hydro_USBL_PCB.PcbDoc
PCB/Hydro_USBL_PCB/Project Outputs for Hydro_USBL_PCB/Sources/Analog_Filter.SchDoc
PCB/Hydro_USBL_PCB/Project Outputs for Hydro_USBL_PCB/Sources/Connectors.SchDoc
PCB/Hydro_USBL_PCB/Project Outputs for Hydro_USBL_PCB/Sources/HV_amplifier.SchDoc
PCB/Hydro_USBL_PCB/Project Outputs for Hydro_USBL_PCB/Sources/Hydro_USBL_PCB.PrjPcb
PCB/Hydro_USBL_PCB/Project Outputs for Hydro_USBL_PCB/Sources/Main.SchDoc
PCB/Hydro_USBL_PCB/Project Outputs for Hydro_USBL_PCB/Sources/MCU.SchDoc
PCB/Hydro_USBL_PCB/Project Outputs for Hydro_USBL_PCB/Sources/Power.SchDoc
