glebmih/Hydro_USBL/(commit log)

2026-05-21 Initial cpmmit
    [BOM.csv, Group Delay.csv, Input Impedance Magnitude.csv, Input Impedance Phase.csv, Magnitude(Volts per Volt).csv, Magnitude(dB).csv, Noise.csv, Phase Delay.csv]
2026-05-31 Power amp schematic added
    [Analog_Filter.SchDoc, HV_amplifier.SchDoc, Hydro_USBL_PCB.PcbDoc, Hydro_USBL_PCB.PrjPcb, MCU.SchDoc, Main.SchDoc, Power.SchDoc]
2026-06-11 Added schematics, protection to filter
    [Analog_Filter.SchDoc, HV_amplifier.SchDoc, Hydro_USBL_PCB.PcbDoc, Hydro_USBL_PCB.PrjPcb, MCU.SchDoc, Main.SchDoc, Power.SchDoc]
2026-06-15 Schematic done
    [Analog_Filter.SchDoc, Connectors.SchDoc, HV_amplifier.SchDoc, Hydro_USBL_PCB.PcbDoc, Hydro_USBL_PCB.PrjPcb, MCU.SchDoc, Main.SchDoc, Power.SchDoc]
2026-06-28 Placement done
    [Analog_Filter.SchDoc, Connectors.SchDoc, HV_amplifier.SchDoc, Hydro_USBL_PCB.PrjPcb, MCU.SchDoc, Main.SchDoc, Power.SchDoc]
2026-07-10 Power polygons
    [Connectors.SchDoc, HV_amplifier.SchDoc, MCU.SchDoc]
2026-07-11 3v3 polygon
    [HV_amplifier.SchDoc, MCU.SchDoc]
2026-07-13 Fixed silk and RELEASE
    [Hydro_USBL_PCB.PrjPcb]
2026-07-13 Fixed outjob
    [Hydro_USBL_PCB.PrjPcb]
2026-07-13 Fixed parameters
    [Connectors.SchDoc, Hydro_USBL_PCB.PrjPcb]
2026-07-15 Fixed error in BOM
    [Connectors.SchDoc]
2026-07-15 Fixed BOM again
2026-07-15 Fixed project parameters
    [Hydro_USBL_PCB.PrjPcb]
2026-07-15 RELEASE 16.07.2026
    [Analog_Filter.SchDoc, Connectors.SchDoc, HV_amplifier.SchDoc, Hydro_USBL_PCB(01).x_t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]
